josephmlevine/waves_on_strings/3dprint/pickup.stl

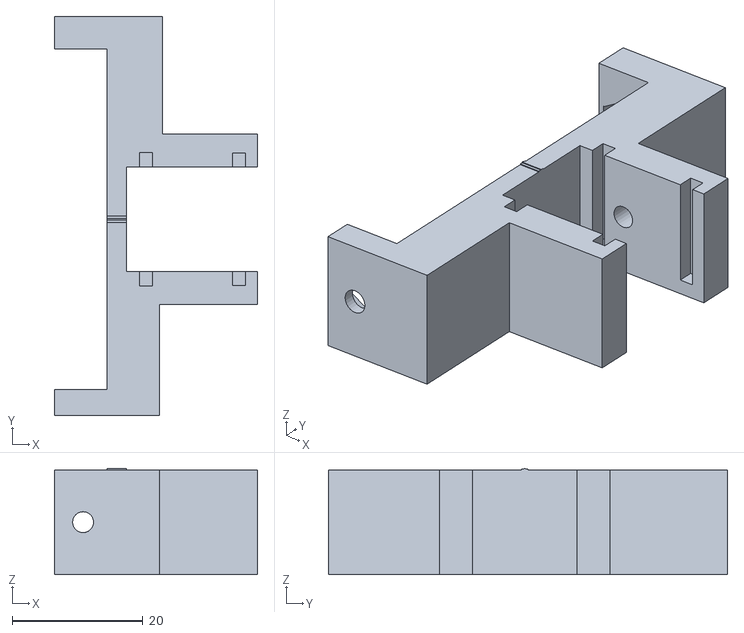
[picture p1: CAD file, 2019-04-21]
3dprint/pickup.stl
31.0 x 61.0 x 16.2
