josephmlevine/waves_on_strings/(list of files, cad)

Other CAD files:
3dprint/pickup_sketchup.skp
