josephmlevine/waves_on_strings/documentation/Wave_on_a_String_manual.pdf

# Standing Waves on a String

Joseph Levine
Kirk Williams

Fall 2018

## 1 Introduction

A plucked guitar string makes a standing wave with many frequencies. The motion of such a string can be represented with a Fourier series, and its frequencies can be analyzed via a Fourier transform. This lab provides an opportunity to compare an analytic solution of a plucked guitar string with real data from different points on the string, provided by optical pickups. An LED shines on a phototransistor in a voltage divider configuration (Figure 1) and is interrupted by the motion of the string. By this method, it can be shown that different frequencies occur with more prevalence at different points on the string because of the locations of the nodes of different wavelengths.

## 2 Apparatus

The experimental setup consists of a “guitar” (Figures 2 and 3) with one string and 5 optical pickups. Half of the apparatus is reserved for plucking at different points, while the other half is for pickups. Points of interest are marked such that lining up the left edge of the pickup’s housing (when viewed with the tuning key on your right) with the line should put the phototransistor at the respective point (±1mm-ish).

### 2.1 Getting started

Each optical pickup has its own output on the main hub. They share a common ground and 5V input, also accessed on the main hub. Ensure you have hooked everything up properly before turning on the 5V supply. Once you have turned it on, the LEDs should glow and you should be ready to take data. Use the simplest LabVIEW program in the universe (attached), and analyze the data in Python (program attached). If you hear a rattling sound coming from the bridge or nut (the aluminum brackets), a quick fix is to loosen the string and put a small piece of paper towel under it.
A thicker gauge string works better (maybe you can figure out why!), but we only tried the thickest and thinnest gauges (the low and high E strings,

1

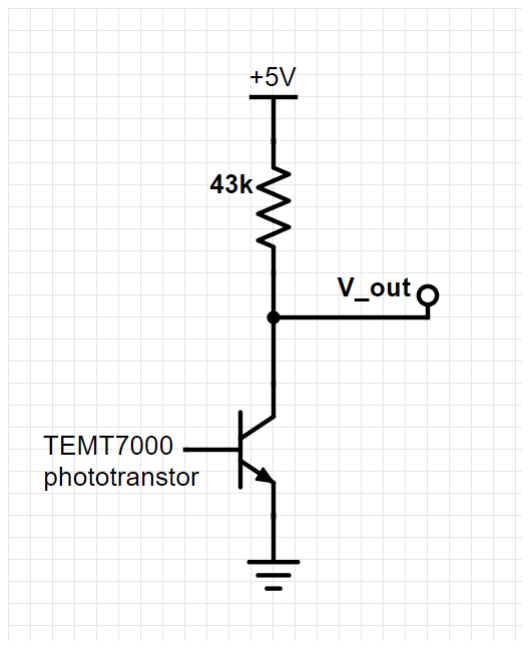
[picture p2: figure]

Figure 1: The phototransistor circuit.

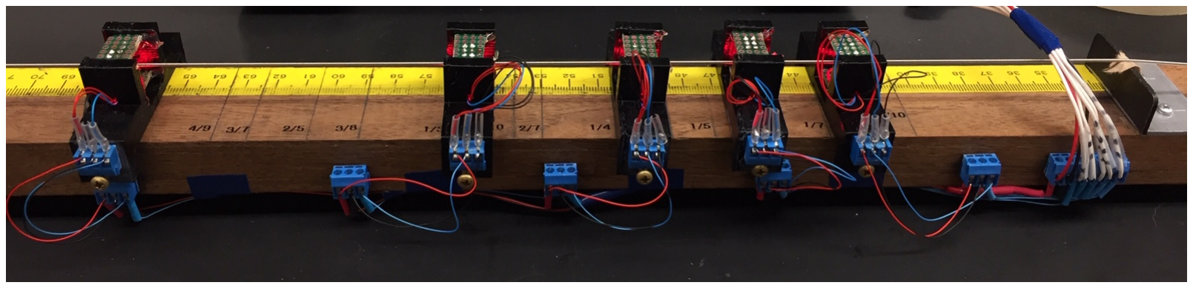
[picture p3: figure]

Figure 2: Side view of the “guitar.”

2

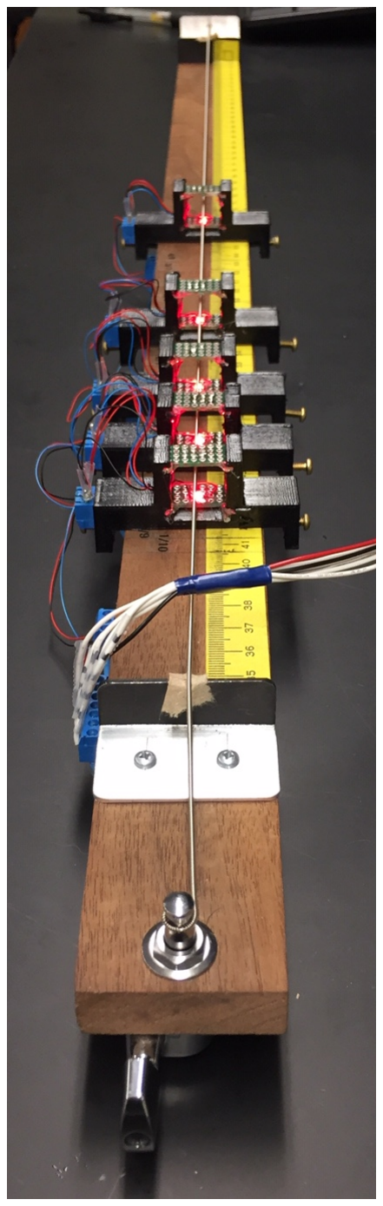
[picture p4: figure]

Figure 3: long view of the “guitar.”

3

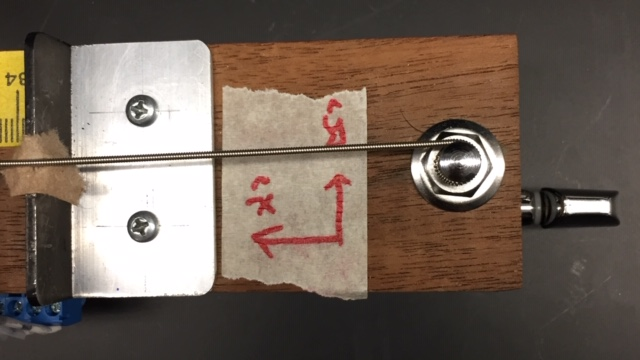
[picture p5: figure]

Figure 4: Axes to reference for pickup adjustment.

respectively. Another distinction between these is that the first is wound with nickel while the second is a plain steel string).
Record data with the lights out or make something to keep a lot of it out. 120 Hz from the lights messes up Python making natural units for you, as it confuses this noise with the fundamental frequency.

### 2.2 Calibration

To get good or even reasonable data, it is important to properly position the pickup in the ˆy-direction (see taped-on axis by tuning key, shown in Figure 4). The phototransistor is small enough that it can be blocked by any size guitar string, so you don’t want them exactly lined up. This will make it impossible for the pickup to show you anything at small amplitudes, as it will be fully blocked. Look at the signal from a pickup and adjust the screws (in increments of about an 8th of a turn) such that the transistor is barely offset from the string. You want to detect small oscillations as the amplitude dies down. Ideally the string at equilibrium would output a voltage of 2.5V, but as long as it isn’t too close to zero or 5V you are ok.
Pickup position in the ˆx direction is what determines what you will see in your Fourier transform. The relative power of different frequencies should tell you whether you are truly close to 1
2

l,

1/3 l,

1/4 l, etc. This can be quickly checked with a dynamic signal analyzer, or more accurately checked by taking a run of data. A higher sample rate will allow you to see higher frequencies, and a longer sample time will give better Fourier resolution.

## 3 Analysis / Ideas to try

There are many possible ways to analyze the data you get from this experiment. Comparison of an analytic solution of the damped wave equation to the instrument’s output is one (see attached Python script). Others could include:

- Curve-fit the decay of the signal and determine the Q-factor of the instrument.

4

- Investigate coupling of the string to the body/bridge (see Figure 5)
- Make a comparison to stationary states in quantum mechanics.
- Build a pickup that holds chips vertically to see vertical polarization and correlate the signal with that from a close-by horizontal pickup.

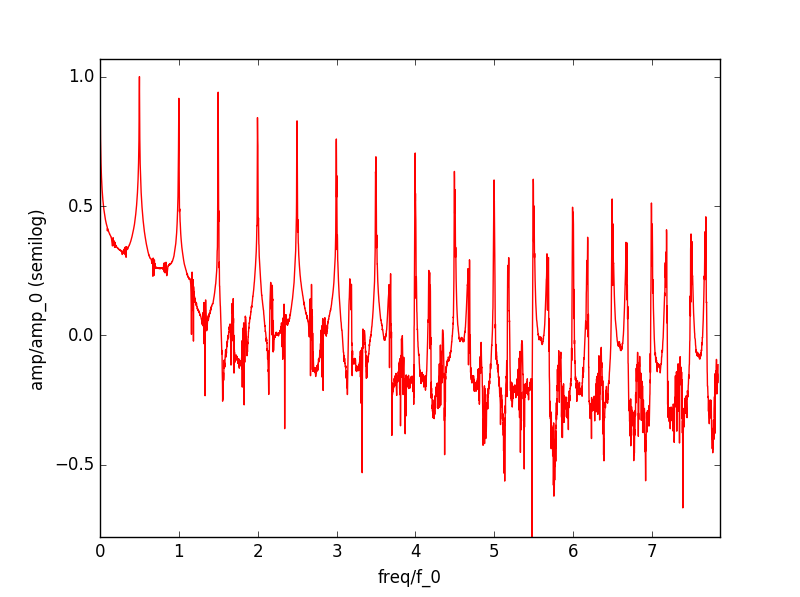
[picture p6: figure]

Figure 5: What’s going on at the higher modes? This is with a high E string (0.010-inch gauge). It looks like coupling but may be an artifact of the thinner string (diffraction?).

5
